Chronos-03/Chronos-keybaord/Images/CAD3.png

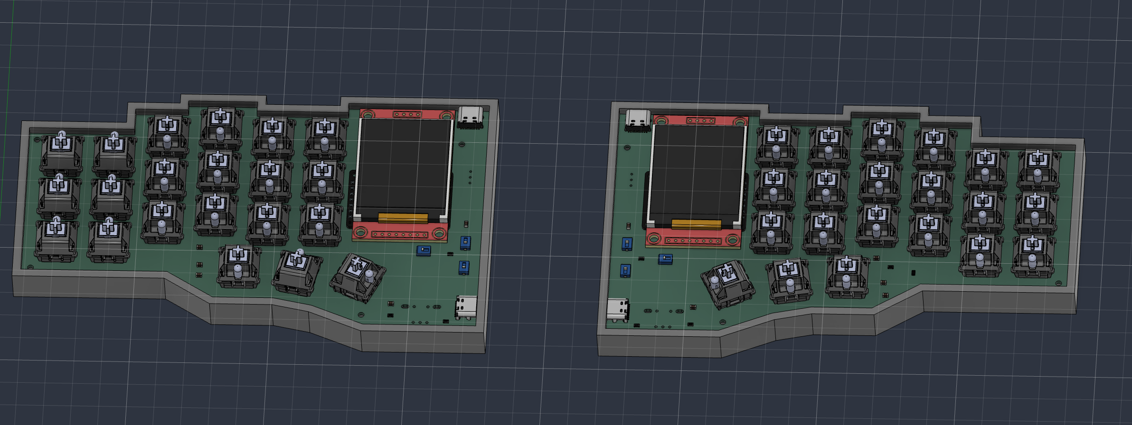
Images/CAD3.png
