Chronos-03/Chronos-keybaord/Images/CAD4.png

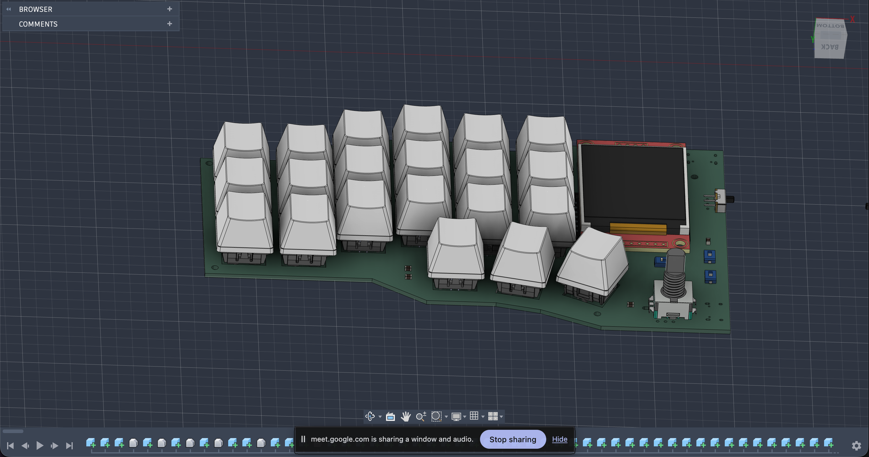
Images/CAD4.png
