Chronos-03/Chronos-keybaord/BOM.md

# Chronos-Keyboard – bill of materials

<!-- Generated by Half Life from project cmuwtn92j0asq01osmgjxy6qj. Edits here are overwritten on the next sync. -->
<!-- Generated: 2026-10-11T19:39:32.990Z -->

> [!NOTE]
> This parts list is mirrored from [Half Life](https://halflife.hackclub.com). Editing it here will not change the platform's copy, and the next sync overwrites this file.

| Week | Tier | Parts funding |
| --- | --- | --- |
| Week 1 | Tier 3 | $100.00 |

| Part | What it's for | Qty | Unit | Total | Vendor |
| --- | --- | --- | --- | --- | --- |
| [ESP32-S3-WROOM-1 Module](https://robu.in/product/espressif-esp32-s3-wroom-1-n4r8-modules/) | MCU | 2 | $4.37 | $8.74 | [Robu.in](https://robu.in/product/espressif-esp32-s3-wroom-1-n4r8-modules/) |
| [Rotatory encoder](https://robu.in/product/hongyan-ec11j-5dm15p1zy15f7-horizontal-encoder-with-switch-ec11-incremental-pulse-rotary-switch-15mm/) | Volume and brightness control | 2 | $0.64 | $1.28 | [Robu.in](https://robu.in/product/hongyan-ec11j-5dm15p1zy15f7-horizontal-encoder-with-switch-ec11-incremental-pulse-rotary-switch-15mm/) |
| [NFC RFID Reader](https://www.indianhobbycenter.com/products/rc522-mini-rfid-reader-writer-spi-s50-with-rfid-card-and-tag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) | For the device unlocking | 2 | $1.44 | $2.88 | [IndianHobbycenter](https://www.indianhobbycenter.com/products/rc522-mini-rfid-reader-writer-spi-s50-with-rfid-card-and-tag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) |
| [20000mAh 3.7V Micro LiPo Batter](https://robu.in/product/nova-103450-2000mah-3-7v-lipo-battery-pack/) | Power Source | 2 | $3.40 | $6.80 | [Robu.in](https://robu.in/product/nova-103450-2000mah-3-7v-lipo-battery-pack/) |
| [TP4056 IC](https://www.ktron.in/product/tp4056-ic/#&gid=1&pid=1) | Charging IC | 2 | $2.00 | $4.00 | [Ktron](https://www.ktron.in/product/tp4056-ic/#&gid=1&pid=1) |
| [ME6211C33M5G](https://robu.in/product/me6211c33m5g-n-microne-500ma-fixed-3-3v-positive-electrode-6v-sot-23-5-voltage-regulators-linear-low-drop-out-ldo-regulators-rohs/) | Regulators | 2 | $0.08 | $0.16 | [Robu.in](https://robu.in/product/me6211c33m5g-n-microne-500ma-fixed-3-3v-positive-electrode-6v-sot-23-5-voltage-regulators-linear-low-drop-out-ldo-regulators-rohs/) |
| [AO3400A-HUASHUO](https://robu.in/product/1-month-warranty-414/) | LED Mosfet | 2 | $0.06 | $0.12 | [robu.in](https://robu.in/product/1-month-warranty-414/) |
| [SMD1206B050TF](https://robu.in/product/smd1206b050tf-yageo-smd1206b050tf-resettable-fuse-pptc-1206-3216-metric-smd1206-series-6-vdc-500-ma-1-a-0-1-s/) | Fuse | 1 | $0.05 | $0.05 | [Robu.in](https://robu.in/product/smd1206b050tf-yageo-smd1206b050tf-resettable-fuse-pptc-1206-3216-metric-smd1206-series-6-vdc-500-ma-1-a-0-1-s/) |
| [TYPE-C](https://robu.in/product/type-c-31-m-12-hroparts-5a-1-16p-female-type-c-smd-usb-connectors-rohs/) | Charging and interconnection | 4 | $0.27 | $1.08 | [Robu.in](https://robu.in/product/type-c-31-m-12-hroparts-5a-1-16p-female-type-c-smd-usb-connectors-rohs/) |
| [1N4148WS](https://robu.in/product/1n4148ws-7-f-multicomp-pro-1n4148ws-7-f-diode-ultrafast-recovery-300ma-75v-sod-323-2/) | Diodes | 50 | $0.12 | $6.00 | [Robu.in](https://robu.in/product/1n4148ws-7-f-multicomp-pro-1n4148ws-7-f-diode-ultrafast-recovery-300ma-75v-sod-323-2/) |
| [LED](https://www.ktron.in/product/smd-white-led-0805-package/) | Backlight | 50 | $0.01 | $0.50 | [ktron.in](https://www.ktron.in/product/smd-white-led-0805-package/) |
| [Resistor](https://www.ktron.in/product/resistor-30k-ohms-1-1-8w-smd-0805/) | Led Protection And other things | 60 | $0.01 | $0.60 | [Ktron.in](https://www.ktron.in/product/resistor-30k-ohms-1-1-8w-smd-0805/) |
| [Capacitors](https://www.ktron.in/product/100nf-100v-ceramic-capacitor-0805/) | for the component electrical stability | 30 | $0.01 | $0.30 | [Ktron](https://www.ktron.in/product/100nf-100v-ceramic-capacitor-0805/) |
| [Gateron Oil King](https://meckeys.com/shop/accessories/keyboard-accessories/key-switches/akko-v3-pro-cream-black-switch/) | Switches | 5 | $2.58 | $12.90 | [Meckeys](https://meckeys.com/shop/accessories/keyboard-accessories/key-switches/akko-v3-pro-cream-black-switch/) |
| [PCB](https://Zbotic.in) | Component Housing | 1 | $45.00 | $45.00 | [Zbotic](https://Zbotic.in) |
| [1.8 TFT display](https://robu.in/product/62060/) | Display | 2 | $3.19 | $6.38 | [Robu.in](https://robu.in/product/62060/) |
| [Slide Switch](https://www.ktron.in/product/slide-switch-1p2t-3a-right-angle/) | Power Control | 2 | $0.12 | $0.24 | [ktron.in](https://www.ktron.in/product/slide-switch-1p2t-3a-right-angle/) |
| [smdswitches](https://makerbazar.in/products/micro-tactile-tact-keys-tasten-smd-push-side-button-schalter) | rebbot and flash | 1 | $0.21 | $0.21 | [MakerBAzar](https://makerbazar.in/products/micro-tactile-tact-keys-tasten-smd-push-side-button-schalter) |
| **Parts subtotal** | — | — | — | **$97.24** | — |
| **Tax & shipping** | — | — | — | **$0.00** | — |
| **Total** | — | — | — | **$97.24** | — |

$2.76 left of the tier's funding.
