Chronos-03/Chronos-keybaord/CAD/FINAL.step

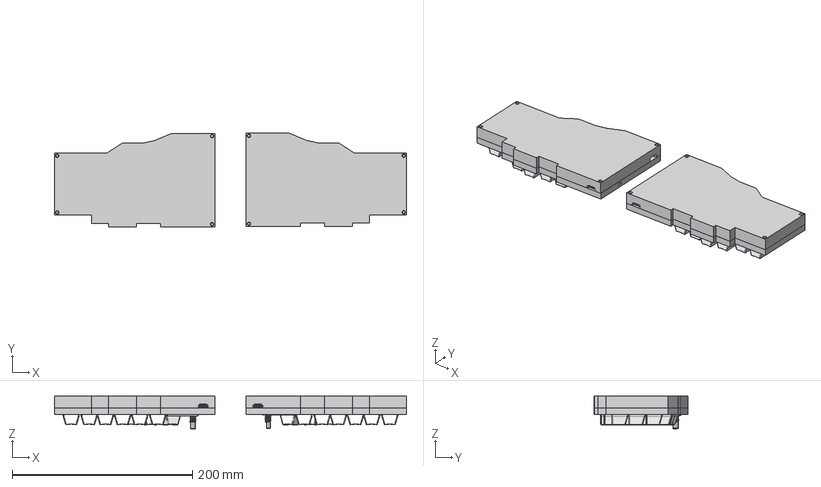
[picture p15: CAD file, 2026-10-11]
CAD/FINAL.step
391.0 x 104.2 x 36.2 mm
SW_SPST_EVQPE002 x 4
SW_SPST_EVQPE1_4 x 4
C_0805_2012Metric_15 x 14
R_0805_2012Metric_52 x 61
C_0805_2012Metric_1
splitkeybaord-unsaved-export-OYqkUO_PCB_1
splitkeybaord-unsaved-export-OYqkUO_PCB_2
