Chronos-03/Chronos-keybaord/CAD/Production/topplate.step

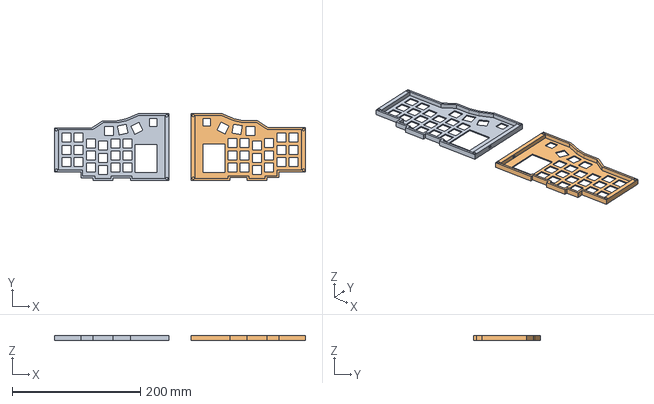
[picture p16: CAD file, 2026-10-11]
CAD/Production/topplate.step
391.0 x 104.2 x 7.10 mm
