Chronos-03/Chronos-keybaord/CAD/Production/Bottom Plates.step

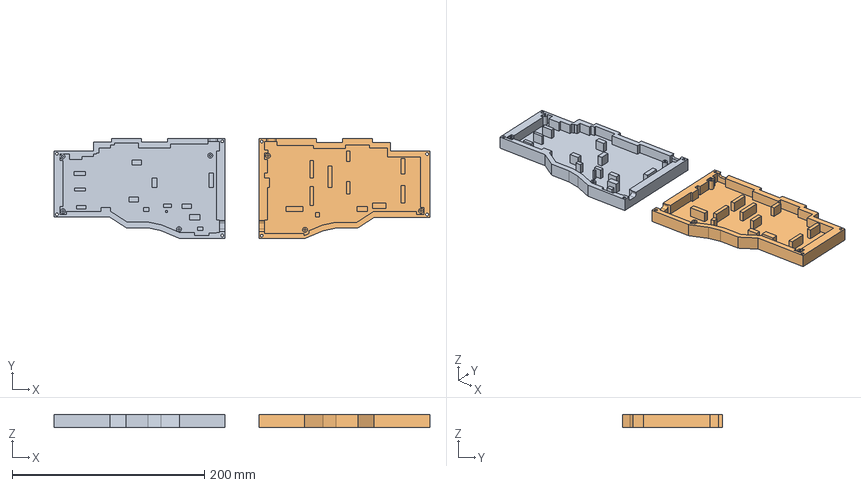
[picture p17: CAD file, 2026-10-11]
CAD/Production/Bottom Plates.step
391.0 x 104.2 x 13.0 mm
