Chronos-03/Chronos-keybaord/CAD/Production/MX 轴标准键帽.STEP

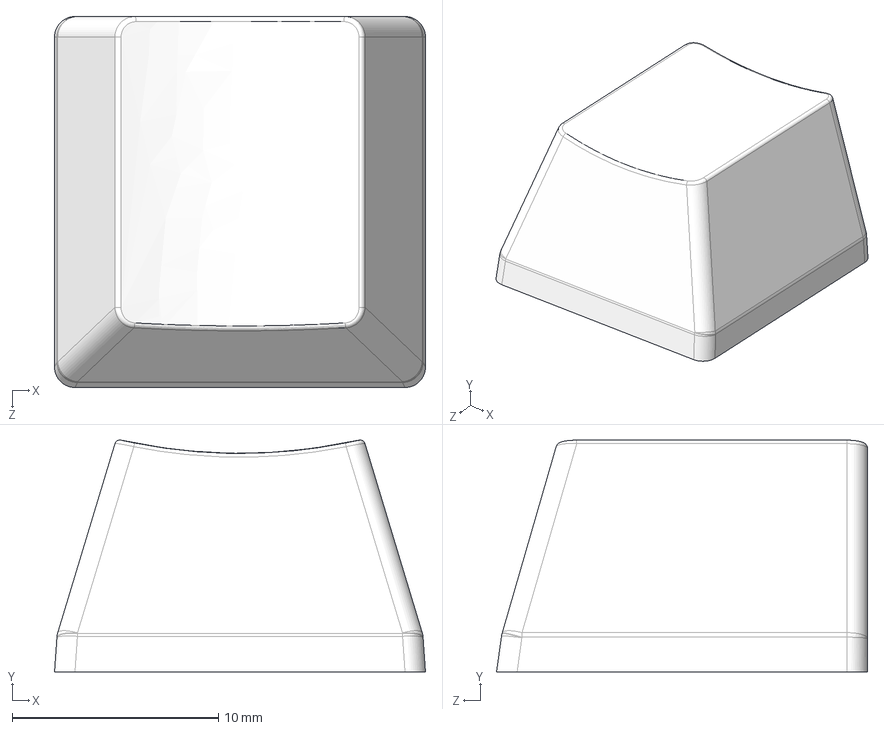
[picture p18: CAD file, 2026-10-11]
CAD/Production/MX 轴标准键帽.STEP
18.0 x 11.3 x 18.0 mm
