Chronos-03/Chronos-keybaord/(list of files, cad)

Other CAD files:
CAD/splitkeyboard.f3z
