Chronos-03/Chronos-keybaord/JOURNAL.md

# Chronos-Keyboard – devlog

<!-- Generated by Half Life from project cmuwtn92j0asq01osmgjxy6qj. Edits here are overwritten on the next sync. -->
<!-- Generated: 2026-10-11T15:53:14.579Z -->

> [!NOTE]
> This devlog is mirrored from [Half Life](https://halflife.hackclub.com). Editing it here will not change the platform's copy, and the next sync overwrites this file.

> Its a split keyboard ofc a polished some cool features like a horizontal encoder custom made one as there are no horizontal encoder available in India so gonna make one also it will be totally wireless with two 2 BT mode and it can also be used at wire mode , have to figure out , it will also have NFC unlocking so we can unlock our device using keyboard just by tapping on the keyboard it gonna be real challenge as we are using MCU and IC not module so micro soldering and SMD soldering as well

| Week | Tier | Hours logged | Entries |
| --- | --- | --- | --- |
| Week 1 | Tier 3 | 30.77h | 19 |

## Contents

1. [2026-10-06 – Work session](#2026-10-06-work-session)
2. [2026-10-06 – Work session](#2026-10-06-work-session)
3. [2026-10-06 – Work session](#2026-10-06-work-session)
4. [2026-10-06 – Work session](#2026-10-06-work-session)
5. [2026-10-06 – Work session](#2026-10-06-work-session)
6. [2026-10-07 – Work session](#2026-10-07-work-session)
7. [2026-10-08 – Work session](#2026-10-08-work-session)
8. [2026-10-09 – Work session](#2026-10-09-work-session)
9. [2026-10-10 – Work session](#2026-10-10-work-session)
10. [2026-10-10 – Work session](#2026-10-10-work-session)
11. [2026-10-10 – Work session](#2026-10-10-work-session)
12. [2026-10-10 – Work session](#2026-10-10-work-session)
13. [2026-10-10 – Work session](#2026-10-10-work-session)
14. [2026-10-10 – Work session](#2026-10-10-work-session)
15. [2026-10-10 – Work session](#2026-10-10-work-session)
16. [2026-10-11 – Work session](#2026-10-11-work-session)
17. [2026-10-11 – Work session](#2026-10-11-work-session)
18. [2026-10-11 – Work session](#2026-10-11-work-session)
19. [2026-10-11 – Work session](#2026-10-11-work-session)

## Design

### 2026-10-06 – Work session

**1.78h**

[Timelapse](https://lookout.hackclub.com/api/media/d517c502-6b8a-4955-9027-b55c1d79c61b/video.mp4)

### 2026-10-06 – Work session

**1.82h**

[Timelapse](https://lookout.hackclub.com/api/media/6f66cf0c-e1ab-4438-bf29-8f8124c79d64/video.mp4)

### 2026-10-06 – Work session

**2.28h**

[Timelapse](https://lookout.hackclub.com/api/media/b791137a-765c-4359-94fb-1bb8a045c5c7/video.mp4)

### 2026-10-06 – Work session

**1.98h**

[Timelapse](https://lookout.hackclub.com/api/media/a3165698-eb34-428c-a0a7-480da84ce9ba/video.mp4)

[Timelapse](https://lookout.hackclub.com/api/media/11c2a8ba-692b-471d-954b-1d789ab9d608/video.mp4)

[Timelapse](https://lookout.hackclub.com/api/media/c890b5a7-5759-471d-8bfb-83db69370aae/video.mp4)

### 2026-10-06 – Work session

**1.88h**

[Timelapse](https://lookout.hackclub.com/api/media/4aa08e74-67c0-4728-a3a8-a8da151a87f8/video.mp4)

### 2026-10-07 – Work session

**1.43h**

[Timelapse](https://lookout.hackclub.com/api/media/2bfc519d-8de2-468b-8159-94312194224b/video.mp4)

### 2026-10-08 – Work session

**2.47h**

[Timelapse](https://lookout.hackclub.com/api/media/1d32d797-5f2f-44f0-8fd3-c943d54c2ceb/video.mp4)

[Timelapse](https://lookout.hackclub.com/api/media/16170b10-85f9-45dd-9ca9-1b2b7a40c692/video.mp4)

### 2026-10-09 – Work session

**2.03h**

[Timelapse](https://lookout.hackclub.com/api/media/550daeff-f781-4979-b747-812ab98d198e/video.mp4)

### 2026-10-10 – Work session

**1.73h**

[Timelapse](https://lookout.hackclub.com/api/media/167b370a-0ebb-4cc4-8d01-54d584ce1895/video.mp4)

[Timelapse](https://lookout.hackclub.com/api/media/03e54c56-acfc-405a-a3a2-cadf27e054c1/video.mp4)

### 2026-10-10 – Work session

**2.85h**

[Timelapse](https://lookout.hackclub.com/api/media/4f58a549-e756-45ca-9425-8f3e6b568386/video.mp4)

[Timelapse](https://lookout.hackclub.com/api/media/c3b077b1-3d88-4d28-b2bd-a6732a2c444d/video.mp4)

[Timelapse](https://lookout.hackclub.com/api/media/f1739039-3a96-4010-a226-d99489004d9f/video.mp4)

### 2026-10-10 – Work session

**1.25h**

[Timelapse](https://lookout.hackclub.com/api/media/9d7534d6-5490-482f-8cf1-cd76b8dd4560/video.mp4)

### 2026-10-10 – Work session

**1.35h**

[Timelapse](https://lookout.hackclub.com/api/media/113dcdc0-0f9f-45e0-b1b3-959f664a9ef0/video.mp4)

### 2026-10-10 – Work session

**0.83h**

[Timelapse](https://lookout.hackclub.com/api/media/d9705a50-5668-4c2b-92c6-969273cd91ea/video.mp4)

### 2026-10-10 – Work session

**1.53h**

[Timelapse](https://lookout.hackclub.com/api/media/3ad77725-bc51-4f3f-b941-7fa1836ff52f/video.mp4)

[Timelapse](https://lookout.hackclub.com/api/media/ebd77ee1-31ee-4e53-bfaf-45f6fa58c572/video.mp4)

### 2026-10-10 – Work session

**0.38h**

[Timelapse](https://lookout.hackclub.com/api/media/1f33a703-db5a-42b7-81ea-8ddda816a1bc/video.mp4)

### 2026-10-11 – Work session

**1.13h**

[Timelapse](https://lookout.hackclub.com/api/media/961719d5-98b0-4d48-9585-8919a445db4d/video.mp4)

### 2026-10-11 – Work session

**1.92h**

[Timelapse](https://lookout.hackclub.com/api/media/23fe84f0-21cb-4575-98ed-22e7d5e0f955/video.mp4)

### 2026-10-11 – Work session

**1.58h**

[Timelapse](https://lookout.hackclub.com/api/media/5a9fae6c-f403-4f18-bea1-87023aaf6cc7/video.mp4)

### 2026-10-11 – Work session

**0.55h**

[Timelapse](https://lookout.hackclub.com/api/media/00e4841c-5cd5-415b-8fc2-d4a035b0fab8/video.mp4)
