Chronos-03/Chronos-keybaord/(commit log)

2026-10-11 minor updates
    [BOM.csv]
2026-10-19 minor changes
    [splitkeybaord.kicad_pcb, splitkeybaord.kicad_sch]
2026-10-19 new changes
    [keybaord.kicad_sch, keyboard.kicad_sch]
